junqilu/LazyOrchids/(commit log)

2025-06-20 added in the issue of using Arduino IDE to edit codes but then use CLion to push
2025-06-20 updated readme about requirements and wiring for supervisor and worker
2025-06-21 uploaded codes for Worker arduino
2025-06-22 corrected the previous header title and moved in the previous global variables since the user doesn't need to see them in the main ino
    [fan.h]
2025-06-22 added in the kickstart for the fan to prevent fan from not rotating; changed the frequency for timer2 to largely reduce the fan noise
    [fan.ino]
2025-06-22 updated readme about reducing fan motor noise
2025-06-25 now the plot min and max and the ideal ranges for temperature are also day/night time sensitive
